jean-claudeF/analogger/Kicad/analogger.sch

## KiCad design Kicad/analogger.sch (2022-01-28)

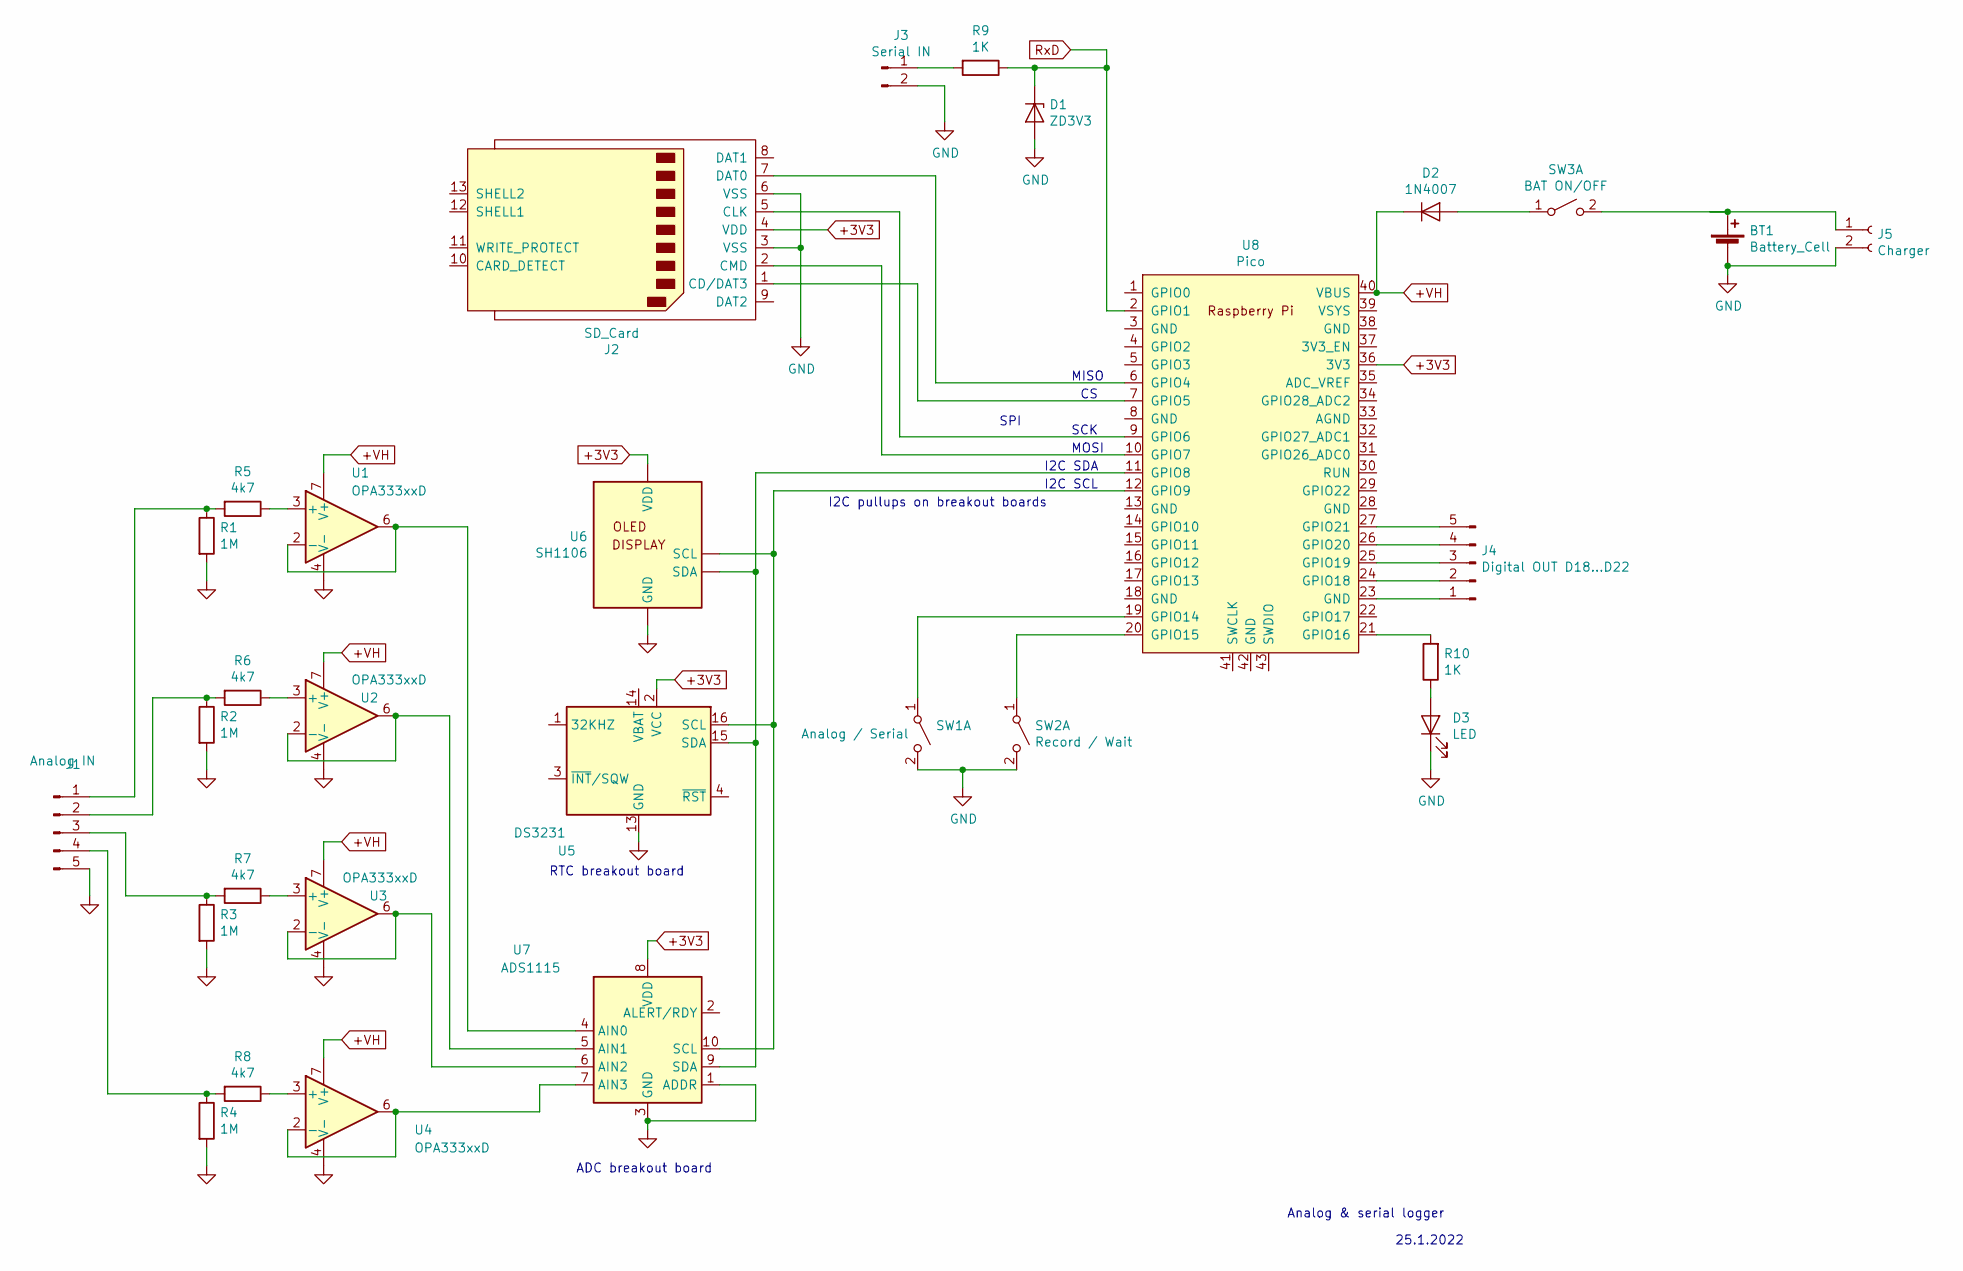
[picture p2: schematic analogger.sch]

Parts:
BT1: Battery_Cell
D1: ZD3V3; D_SMF
D2: 1N4007
D3: LED
J1: Analog IN
J2: SD_Card
J3: Serial IN
J4: Digital OUT D18...D22
J5: Charger
R1, R2, R3, R4: 1M
R5, R6, R7, R8: 4k7
R9, R10: 1K
SW1: Analog / Serial
SW2: Record / Wait
SW3: BAT ON/OFF
U1, U2, U3, U4: OPA333xxD; SOIC-8_3.9x4.9mm_P1.27mm
U5: DS3231; SOIC-16W_7.5x10.3mm_P1.27mm
U6: SH1106
U7: ADS1115; TSSOP-10_3x3mm_P0.5mm
U8: Pico; RPi_Pico_SMD_TH

Connections:
+3V3: J2.4 (VDD), U5.2 (VCC), U6.8 (VDD), U7.8 (VDD), U8.36 (3V3)
+VH: D2.1 (K), U1.7 (V+), U2.7 (V+), U3.7 (V+), U4.7 (V+), U8.40 (VBUS)
GND: BT1.2 (-), D1.2 (A), D3.1 (K), J1.5, J2.3 (VSS), J2.6 (VSS), J3.2, J5.2, R1.2, R2.2, R3.2, R4.2, SW1.2 (B), SW2.2 (B), U1.4 (V-), U2.4 (V-), U3.4 (V-), U4.4 (V-), U5.5 (GND), U5.6 (GND), U5.7 (GND), U5.8 (GND), U5.9 (GND), U5.10 (GND), U5.11 (GND), U5.12 (GND), U5.13 (GND), U6.3 (GND), U7.1 (ADDR), U7.3 (GND)
unnamed: BT1.1 (+), J5.1, SW3.2 (B)
unnamed: D2.2 (A), SW3.1 (A)
unnamed: D3.2 (A), R10.1
unnamed: J1.1, R1.1, R5.2
unnamed: J1.2, R2.1, R6.2
unnamed: J1.3, R3.1, R7.2
unnamed: J1.4, R4.1, R8.2
unnamed: J2.1 (CD/DAT3), U8.7 (GPIO5)
unnamed: J2.2 (CMD), U8.10 (GPIO7)
unnamed: J2.5 (CLK), U8.9 (GPIO6)
unnamed: J2.7 (DAT0), U8.6 (GPIO4)
unnamed: J3.1, R9.2
unnamed: J4.1, U8.23 (GND)
unnamed: J4.2, U8.24 (GPIO18)
unnamed: J4.3, U8.25 (GPIO19)
unnamed: J4.4, U8.26 (GPIO20)
unnamed: J4.5, U8.27 (GPIO21)
unnamed: R5.1, U1.3 (+)
unnamed: R6.1, U2.3 (+)
unnamed: R7.1, U3.3 (+)
unnamed: R8.1, U4.3 (+)
unnamed: R10.2, U8.21 (GPIO16)
unnamed: SW1.1 (A), U8.19 (GPIO14)
unnamed: SW2.1 (A), U8.20 (GPIO15)
unnamed: U1.2 (-), U1.6, U7.4 (AIN0)
unnamed: U2.2 (-), U2.6, U7.5 (AIN1)
unnamed: U3.2 (-), U3.6, U7.6 (AIN2)
unnamed: U4.2 (-), U4.6, U7.7 (AIN3)
unnamed: U5.15 (SDA), U6.9 (SDA), U7.9 (SDA), U8.11 (GPIO8)
unnamed: U5.16 (SCL), U6.10 (SCL), U7.10 (SCL), U8.12 (GPIO9)
RxD: D1.1 (K), R9.1, U8.2 (GPIO1)

Notes on the sheet:
MISO
SCK
MOSI
I2C SCL
I2C SDA
SPI
RTC breakout board
ADC breakout board
Analog & serial logger
25.1.2022
I2C pullups on breakout boards
