jean-claudeF/analogger/Micropython/OLED_SH1106_02.py

#
# MicroPython SH1106 OLED driver, I2C and SPI interfaces
#
# The MIT License (MIT)
#
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
# Sample code sections for ESP8266 pin assignments
# ------------ SPI ------------------
# Pin Map SPI
#   - 3v - xxxxxx   - Vcc
#   - G  - xxxxxx   - Gnd
#   - D7 - GPIO 13  - Din / MOSI fixed
#   - D5 - GPIO 14  - Clk / Sck fixed
#   - D8 - GPIO 4   - CS (optional, if the only connected device)
#   - D2 - GPIO 5   - D/C
#   - D1 - GPIO 2   - Res
#
# for CS, D/C and Res other ports may be chosen.
#
# from machine import Pin, SPI
# import sh1106

# spi = SPI(1, baudrate=1000000)
# display = sh1106.SH1106_SPI(128, 64, spi, Pin(5), Pin(2), Pin(4))
# display.sleep(False)
# display.fill(0)
# display.text('Testing 1', 0, 0, 1)
# display.show()
#
# --------------- I2C ------------------
#
# Pin Map I2C
#   - 3v - xxxxxx   - Vcc
#   - G  - xxxxxx   - Gnd
#   - D2 - GPIO 5   - SCK / SCL
#   - D1 - GPIO 4   - DIN / SDA
#   - D0 - GPIO 16  - Res
#   - G  - xxxxxx     CS
#   - G  - xxxxxx     D/C
#
# Pin's for I2C can be set almost arbitrary
#
# from machine import Pin, I2C
# import sh1106
#
# i2c = I2C(scl=Pin(5), sda=Pin(4), freq=400000)
# display = sh1106.SH1106_I2C(128, 64, i2c, Pin(16), 0x3c)
# display.sleep(False)
# display.fill(0)
# display.text('Testing 1', 0, 0, 1)
# display.show()

# The actual text output or drawing functions are done by the framebuf class!



from micropython import const
import utime as time
import framebuf


# a few register definitions
_SET_CONTRAST        = const(0x81)
_SET_NORM_INV        = const(0xa6)
_SET_DISP            = const(0xae)
_SET_SCAN_DIR        = const(0xc0)
_SET_SEG_REMAP       = const(0xa0)
_LOW_COLUMN_ADDRESS  = const(0x00)
_HIGH_COLUMN_ADDRESS = const(0x10)
_SET_PAGE_ADDRESS    = const(0xB0)


class SH1106:
    def __init__(self, width, height, external_vcc, rotate=0):
        self.width = width
        self.height = height
        self.external_vcc = external_vcc
        self.flip_en = rotate == 180 or rotate == 270
        self.rotate90 = rotate == 90 or rotate == 270
        self.pages = self.height // 8
        self.bufsize = self.pages * self.width
        self.renderbuf = bytearray(self.bufsize)
        if self.rotate90:
            self.displaybuf = bytearray(self.bufsize)
            # HMSB is required to keep the bit order in the render buffer
            # compatible with byte-for-byte remapping to the display buffer,
            # which is in VLSB. Else we'd have to copy bit-by-bit!
            fb = framebuf.FrameBuffer(self.renderbuf, self.height, self.width,
                                      framebuf.MONO_HMSB)
        else:
            self.displaybuf = self.renderbuf
            fb = framebuf.FrameBuffer(self.renderbuf, self.width, self.height,
                                      framebuf.MONO_VLSB)

        # flip() was called rotate() once, provide backwards compatibility.
        self.rotate = self.flip

        # set shortcuts for the methods of framebuf
        self.fill = fb.fill
        self.fill_rect = fb.fill_rect
        self.hline = fb.hline
        self.vline = fb.vline
        self.line = fb.line
        self.rect = fb.rect
        self.pixel = fb.pixel
        self.scroll = fb.scroll
        self.text = fb.text
        self.blit = fb.blit

        self.init_display()
        
        # added JCF:
        self.currentline = 0
        self.maxline = 5

    def init_display(self):
        self.reset()
        self.fill(0)
        self.poweron()
        # rotate90 requires a call to flip() for setting up.
        self.flip(self.flip_en)

    def poweroff(self):
        self.write_cmd(_SET_DISP | 0x00)

    def poweron(self):
        self.write_cmd(_SET_DISP | 0x01)

    def flip(self, flag=None, update=True):
        if flag is None:
            flag = not self.flip_en
        mir_v = flag ^ self.rotate90
        mir_h = flag
        self.write_cmd(_SET_SEG_REMAP | (0x01 if mir_v else 0x00))
        self.write_cmd(_SET_SCAN_DIR | (0x08 if mir_h else 0x00))
        self.flip_en = flag
        if update:
            self.show()

    def sleep(self, value):
        self.write_cmd(_SET_DISP | (not value))

    def contrast(self, contrast):
        self.write_cmd(_SET_CONTRAST)
        self.write_cmd(contrast)

    def invert(self, invert):
        self.write_cmd(_SET_NORM_INV | (invert & 1))

    def show(self):
        # self.* lookups in loops take significant time (~4fps).
        (w, p, db, rb) = (self.width, self.pages,
                          self.displaybuf, self.renderbuf)
        if self.rotate90:
            for i in range(self.bufsize):
                db[w * (i % p) + (i // p)] = rb[i]
        for page in range(self.height // 8):
            self.write_cmd(_SET_PAGE_ADDRESS | page)
            self.write_cmd(_LOW_COLUMN_ADDRESS | 2)
            self.write_cmd(_HIGH_COLUMN_ADDRESS | 0)
            self.write_data(db[(w*page):(w*page+w)])

    def reset(self, res):
        if res is not None:
            res(1)
            time.sleep_ms(1)
            res(0)
            time.sleep_ms(20)
            res(1)
            time.sleep_ms(20)

#-------------------------------------------------------------
# added by jean-claude.feltes@education.lu:
    def write_line(self, text, line):
        '''write text to OLED into line 0...5'''
        self.text(text, 0, line * 10)
        self.show()


    def print(self, text):
        '''print string s to OLED and automatically go to next row
           with clear before line 0'''
        if self.currentline == 0:
            self.fill(0)
        self.write_line(text,  self.currentline )
        self.currentline += 1
        if self.currentline > self.maxline:
            self.currentline = 0
        
        
    def print_s(self, s, separator = '\t'):
        '''print string s to OLED
        s -> multiple rows, separated by '\t'   '''
        
        sarray = s.split(separator)
        self.fill(0)
        self.currentline = 0
        for item in sarray:
            #self.print(item)
            self.text(item, 0, self.currentline * 10)
            self.currentline += 1
            if self.currentline > self.maxline:
                self.currentline = 0
        self.show()    

    def clear(self):
        self.fill(0)
        
#----------------------------------------------------------------
class SH1106_I2C(SH1106):
    def __init__(self, width, height, i2c, res=None, addr=0x3c,
                 rotate=0, external_vcc=False):
        self.i2c = i2c
        self.addr = addr
        self.res = res
        self.temp = bytearray(2)
        if res is not None:
            res.init(res.OUT, value=1)
        super().__init__(width, height, external_vcc, rotate)

    def write_cmd(self, cmd):
        self.temp[0] = 0x80  # Co=1, D/C#=0
        self.temp[1] = cmd
        self.i2c.writeto(self.addr, self.temp)

    def write_data(self, buf):
        self.i2c.writeto(self.addr, b'\x40'+buf)

    def reset(self):
        super().reset(self.res)


class SH1106_SPI(SH1106):
    def __init__(self, width, height, spi, dc, res=None, cs=None,
                 rotate=0, external_vcc=False):
        self.rate = 10 * 1000 * 1000
        dc.init(dc.OUT, value=0)
        if res is not None:
            res.init(res.OUT, value=0)
        if cs is not None:
            cs.init(cs.OUT, value=1)
        self.spi = spi
        self.dc = dc
        self.res = res
        self.cs = cs
        super().__init__(width, height, external_vcc, rotate)

    def write_cmd(self, cmd):
        self.spi.init(baudrate=self.rate, polarity=0, phase=0)
        if self.cs is not None:
            self.cs(1)
            self.dc(0)
            self.cs(0)
            self.spi.write(bytearray([cmd]))
            self.cs(1)
        else:
            self.dc(0)
            self.spi.write(bytearray([cmd]))

    def write_data(self, buf):
        self.spi.init(baudrate=self.rate, polarity=0, phase=0)
        if self.cs is not None:
            self.cs(1)
            self.dc(1)
            self.cs(0)
            self.spi.write(buf)
            self.cs(1)
        else:
            self.dc(1)
            self.spi.write(buf)

    def reset(self):
        super().reset(self.res)
#----------------------------------------------------------------------------------------------------------
        
if __name__ == "__main__":
    from machine import Pin, I2C
    import time


    i2c = I2C(0, scl=Pin(9), sda=Pin(8))
    oled = SH1106_I2C(128, 64, i2c)
    
    def test1():
        oled.clear()
        oled.print("TEST OLED PRINT")
        for i in range(0,8):
            #oled.print_line("TEST " + str(i))
            oled.print("TEST " + str(i))
            time.sleep(0.2)
            oled.show()

    def test2():
        oled.clear()

        oled.text("TEST OLED", 0, 0)      # text, x, y, colour (1 = white)     
        #oled.text("TEST OLED",5,5)
        oled.text("by JCF",5,15)
        oled.text("Another row", 5, 25)
        oled.text("Yet another row", 5, 35)
        oled.text("And one more", 5, 45)
        oled.show()



    def test3():
        oled.clear()
        oled.text("TEST ", 30, 0)             
        oled.hline(10,10, 20, 1)
        oled.vline(10, 20, 30, 1)
        oled.line(10, 10, 50, 50, 1)
        oled.rect(20, 20, 60, 40, 1)
        oled.fill_rect(80, 20, 20, 20, 1)
        oled.show()



    def test4():
        oled.clear()
        for i in range(0,6):
            #oled.print_line("TEST LINE" + str(i))
            oled.print("TEST LINE" + str(i))
        oled.show()               

    def test5():
        s = "Hello \t world \t ! \t 3.14     \t The answer is \t 42"
        oled.print_s(s)
        '''
        time.sleep(1)
        s = "123456789 \t ! \t 3.14     \t The answer is \t 42\t Hitchhiker"
        oled.print_s(s) 
        '''
        
    def test_all():
        test1()
        time.sleep(1)
        test2()
        time.sleep(1)
        test3()
        time.sleep(1)
        test4()
        time.sleep(1)
        test5()
        time.sleep(1)
        
    
    test_all()
    #test5()
    
